Dygmalab/raise-right-asym/README.md

# raise-right-asym
Right side PCB of the Dygma Raise keyboard

Licensed under CERN-OHL and distributed as is without any additional warranty or documentation.

#### Usefull links
[Neuron](https://github.com/Dygmalab/neuron)

[Right side schematics](https://github.com/Dygmalab/raise-right-asym)

[Right bottom schematics](https://github.com/Dygmalab/right-lp)

[Left side schematics](https://github.com/Dygmalab/raise-left)

[Left bottom schematics](https://github.com/Dygmalab/left-lp)
