Dygmalab/raise-right-asym/(commit log)

2017-09-08 sent to fab
    [raise-right.kicad_pcb, raise-right.sch]
2017-09-12 changes for asymetric right
    [raise-right.kicad_pcb, raise-right.sch]
2017-09-12 positions fixed
    [raise-right-asym.kicad_pcb]
2017-09-12 ready for fab
    [raise-right-asym.kicad_pcb]
2017-10-06 note on number of keys
    [raise-right-asym.sch]
2017-10-06 added dimensions
    [raise-right-asym.kicad_pcb]
2017-10-06 key layout for v4
    [ledmatrix.sch, raise-right-asym.kicad_pcb, raise-right-asym.sch]
2017-10-06 keys laid out, pre led positioning
    [raise-right-asym.kicad_pcb]
2017-10-07 led fp
    [ledmatrix.sch, raise-right-asym.kicad_pcb, raise-right-asym.sch]
2017-10-11 fab with 0.16 clearance
    [ledmatrix.sch, raise-right-asym.kicad_pcb, raise-right-asym.sch]
2017-10-13 component order codes
    [ledmatrix.sch, raise-right-asym.kicad_pcb, raise-right-asym.sch]
2017-11-07 fixes for v4.2
    [ledmatrix.sch, raise-right-asym.kicad_pcb, raise-right-asym.sch]
2017-11-07 v4.2 export
    [ledmatrix.sch, raise-right-asym.kicad_pcb, raise-right-asym.sch]
2017-11-07 exported v4.2
    [raise-right-asym.kicad_pcb]
2017-12-11 fix led problem
    [raise-right-asym.sch]
2017-12-20 new holes, new outlines
    [ledmatrix.sch, raise-right-asym.kicad_pcb, raise-right-asym.sch]
2017-12-28 usb connector moved
    [raise-right-asym.kicad_pcb]
2018-01-02 new footprints
    [ledmatrix.sch, raise-right-asym.kicad_pcb, raise-right-asym.sch]
2018-03-20 full BOM info on parts
    [ledmatrix.sch, raise-right-asym.kicad_pcb, raise-right-asym.sch]
2018-04-05 changed fp name of sled and added the J to part number
    [ledmatrix.sch]
2018-04-05 fp change for sled - same fp different name
    [raise-right-asym.kicad_pcb]
2018-04-24 layout wip
    [ledmatrix.sch, raise-right-asym.kicad_pcb, raise-right-asym.sch]
2018-05-08 wip layout
    [ledmatrix.sch, raise-right-asym.kicad_pcb, raise-right-asym.sch]
2018-05-09 changed switch and led numbering, re-laid out components, started routing
    [ledmatrix.sch, raise-right-asym.kicad_pcb, raise-right-asym.sch]
2018-05-21 moved footprints to submodule
    [raise-right-asym.kicad_pcb, raise-right-asym.sch]
2018-05-25 reverse leds
    [ledmatrix.sch]
2018-05-25 removed old libs
    [raise-right-asym.sch]
2018-05-25 models and reverse leds
    [raise-right-asym.kicad_pcb]
2018-05-30 reverse led fix
2018-05-30 3d export for leds
    [raise-right-asym.kicad_pcb]
2018-06-07 pre align
    [ledmatrix.sch, raise-right-asym.kicad_pcb, raise-right-asym.sch]
2018-06-07 post align
    [raise-right-asym.kicad_pcb, raise-right-asym.sch]
2018-06-07 leds and diodes fixed
    [raise-right-asym.kicad_pcb]
2018-06-07 fixed diodes
    [ledmatrix.sch, raise-right-asym.kicad_pcb, raise-right-asym.sch]
2018-06-20 new alignment
    [raise-right-asym.kicad_pcb, raise-right-asym.sch]
2018-06-21 pre routing
    [raise-right-asym.kicad_pcb, raise-right-asym.sch]
2018-06-27 iso/ansi component naming
    [ledmatrix.sch, raise-right-asym.kicad_pcb, raise-right-asym.sch]
2018-06-28 pre autoroute
    [ledmatrix.sch, raise-right-asym.kicad_pcb]
2018-06-28 led footprint with +
    [raise-right-asym.kicad_pcb]
2018-06-28 routed after led pinout change
    [raise-right-asym.kicad_pcb]
2018-06-29 ansi/iso bom
    [ledmatrix.sch, raise-right-asym.sch]
2018-07-03 pcb colours
2018-07-03 fix qfn56->46 fp name
    [ledmatrix.sch]
2018-07-03 fix hole position
    [raise-right-asym.kicad_pcb]
2018-07-25 fixes for gp
    [ledmatrix.sch, raise-right-asym.kicad_pcb, raise-right-asym.sch]
2018-07-26 flipped components for proper position file export
    [raise-right-asym.kicad_pcb]
2018-08-14 avcc to +5v
    [raise-right-asym.kicad_pcb, raise-right-asym.sch]
2018-09-05 add inductor name to component value
    [raise-right-asym.sch]
2018-09-05 changed 47uf ceramic to tantalum
    [ledmatrix.sch, raise-right-asym.kicad_pcb, raise-right-asym.sch]
2018-09-06 derated tantalum to 10v
    [ledmatrix.sch, raise-right-asym.kicad_pcb]
2018-09-11 new holes and outline
    [raise-right-asym.kicad_pcb]
2018-09-11 new lp led and label name changes to fix ERC
    [ledmatrix.sch, raise-right-asym.sch]
2018-09-11 new lp led
2018-09-11 switch to raise fp for tantalum
2018-09-12 moved hole and updated usb c z pos
    [raise-right-asym.kicad_pcb]
2018-09-13 final checks
    [raise-right-asym.kicad_pcb]
2018-09-18 changed to 2.2mm mount holes
    [raise-right-asym.kicad_pcb, raise-right-asym.sch]
2018-11-15 remove lib
    [ledmatrix.sch]
2018-11-15 100pf on input, 10uf bypass cap for hall and avcc, testpoints for switches
    [raise-right-asym.sch]
2018-11-15 moved hall, usb C paste layer
    [raise-right-asym.kicad_pcb]
2018-11-15 fix minor silk issue
    [raise-right-asym.kicad_pcb]
2018-12-13 holes to 4mm, sled testpoints, usbC mask on locator points, diode and cap fp improvements
    [raise-right-asym.kicad_pcb, raise-right-asym.sch]
2018-12-13 usb C socket change to circular mask
    [raise-right-asym.kicad_pcb]
2018-12-14 add extra ground plane for usbC socket security, label col/row testpoints
    [raise-right-asym.kicad_pcb]
2018-12-17 added big pads for USBC
    [raise-right-asym.kicad_pcb]
2018-12-21 SMT attribute: usb C change to SMD, DNP resistor and logo change to virtual
    [raise-right-asym.kicad_pcb]
2018-12-21 change fiducial to SMD type
    [raise-right-asym.kicad_pcb]
2019-01-14 add pin 1 refs to ics
    [raise-right-asym.kicad_pcb]
2019-02-01 increase hole size and add keepouts for all leds cutouts
    [raise-right-asym.kicad_pcb]
2019-02-12 new version
    [raise-right-asym.kicad_pcb]
2019-02-12 added esd protection to sda/scl/reset/cc
    [ledmatrix.sch, raise-right-asym.kicad_pcb, raise-right-asym.sch]
2019-02-14 fix too close wire
    [raise-right-asym.kicad_pcb]
2019-02-27 part numbers
    [ledmatrix.sch, raise-right-asym.sch]
2019-04-01 change programming header to virtual to avoid pads on solder stencil
    [raise-right-asym.kicad_pcb]
2019-04-01 start routing
    [ledmatrix.sch, raise-right-asym.kicad_pcb, raise-right-asym.sch]
2019-04-01 tiny routed
    [raise-right-asym.kicad_pcb]
2019-04-01 sled routed
    [raise-right-asym.kicad_pcb]
2019-04-01 key matrix routed
    [raise-right-asym.kicad_pcb]
2019-04-01 80% led matrix
    [raise-right-asym.kicad_pcb]
2019-04-02 finish wiring
    [raise-right-asym.kicad_pcb]
2019-04-02 DRC text and remove old zone
    [raise-right-asym.kicad_pcb]
2019-04-02 consolidate parts and farnell numbers
    [ledmatrix.sch, raise-right-asym.kicad_pcb, raise-right-asym.sch]
2019-04-02 fix sled fp
    [raise-right-asym.kicad_pcb]
2019-04-03 bom consolidation
    [ledmatrix.sch, raise-right-asym.sch]
2019-04-04 give values for testpoints for the align script
    [raise-right-asym.kicad_pcb, raise-right-asym.sch]
2019-04-08 fixed tracks outside board edge
    [raise-right-asym.kicad_pcb]
2019-04-18 fixed wrong DNP 0R resistors
    [ledmatrix.sch, raise-right-asym.sch]
2019-04-23 fix 0R names, set filter caps to virtual in PCB
    [raise-right-asym.kicad_pcb]
2019-06-20 move resistor labels
    [raise-right-asym.sch]
2019-06-20 used new reverse mount led footprint
    [raise-right-asym.kicad_pcb]
2019-06-20 added git version to top side
    [raise-right-asym.kicad_pcb]
2019-07-05 datasheet for pmos
    [raise-right-asym.sch]
2019-07-24 kailh socket holes increased from 3 to 3.05mm
    [raise-right-asym.kicad_pcb]
2019-12-19 fix missing models
    [raise-right-asym.kicad_pcb]
